thomas-lamure/totobox/docs/api.md

# API embarquée

La page web ([web/](../web)) ne parle à la boîte que par cette API JSON locale. Elle reste simple et utilisable depuis un script (`curl`). Le faux serveur de développement ([scripts/mock-server.mjs](../scripts/mock-server.mjs), voir [development.md](development.md#page-web)) l'imite sans matériel.

Erreurs communes: `403 locked` (réglages verrouillés), `503 busy_playing` (accès à la carte SD refusé pendant la lecture), `503 busy_downloading` (même chose pendant un téléchargement), `403 forbidden_host`, `403 forbidden_origin` et `415 json_required` (voir « Protection contre les autres sites »).

Colonnes « Verrouillée » et « En lecture »: la route est-elle servie? Elles reprennent la table du firmware ([src/api_routes.cpp](../src/api_routes.cpp)), vérifiée par `make test-scripts`.

| Route | Verrouillée | En lecture | Rôle |
|---|---|---|---|
| `GET /` | oui | oui | page web |
| `GET /api/status` | oui | oui | état, lecture en cours, volume, verrouillage, SD |
| `POST /api/volume` | oui | oui | `{volume}` borné aux limites |
| `POST /api/unlock` | oui | oui | `{pin}`; 5 erreurs = 60 s de blocage |
| `POST /api/lock` | oui | oui | reverrouille |
| `GET /api/config` | non | oui | réglages, bindings, cartes maîtresses |
| `POST /api/config` | non | oui | réglages (mot de passe absent = inchangé), `hostname`, `updateNotify`, `autoUpdate`, Home Assistant (voir plus bas); validés, réseau appliqué sans redémarrage |
| `POST /api/bindings` | non | oui | remplace la liste des cartes |
| `POST /api/lock/setup` | non | oui | `{enabled:true, cardUid, cardLabel, pin}` ou `{enabled:false}` |
| `POST /api/lock/pin` | non | oui | `{pin}` |
| `POST /api/lock/cards` | non | oui | `{action:"add"/"remove", cardUid, cardLabel}` |
| `GET /api/library` | non | non | arborescence de `/content`, espace SD |
| `POST /api/upload` | non | non | multipart, tags ID3 retirés à l'écriture. La page envoie un fichier par requête (file d'envoi annulable); un envoi interrompu (annulé, connexion perdue) efface le fichier à moitié écrit |
| `GET /api/download?path=` | non | non | fichier audio de `/content` (hors corbeille) en pièce jointe (`Content-Disposition`, nom UTF-8); un dossier part en archive ZIP sans compression (`dossier.zip`, `totobox.zip` pour `/content`, sous-dossiers compris, fichiers audio seulement, 2000 fichiers et 4 Go au plus). Envoyé par morceaux sans bloquer la boîte, interrompu si une histoire démarre. Un seul à la fois. Erreurs: `invalid_path`, `not_found`, `sd_unavailable`, `empty_folder`, `too_many_files`, `too_large` |
| `POST /api/folder` | non | non | crée un dossier |
| `POST /api/rename` | non | non | renomme fichier ou dossier |
| `POST /api/move` | non | non | `{path, targetDir}`: déplace fichier ou dossier, renvoie `movedPath` |
| `POST /api/delete` | non | non | déplace vers `/content/.trash` |
| `GET /api/trash` | non | non | contenu de la corbeille |
| `POST /api/restore` | non | non | restaure depuis la corbeille; les dossiers de la corbeille vidés sont retirés |
| `POST /api/trash/purge` | non | non | vide la corbeille, ou `{path}`: supprime définitivement un seul élément de la corbeille (les dossiers de la corbeille vidés sont retirés) |
| `GET /api/cards/backup` | non | non | sauvegarde présente sur la SD: `exists`, `count`, `savedAt` |
| `POST /api/cards/backup` | non | non | `{savedAt}`: sauvegarde les cartes dans `/totobox-cartes.json` (remplace la précédente) |
| `POST /api/cards/restore` | non | non | remplace les cartes par celles de la sauvegarde (cartes maîtresses ignorées) |
| `POST /api/setup/complete` | non | oui | assistant de première connexion terminé (ou remis à plus tard) |
| `POST /api/factory-reset` | non | non | `{confirm:"EFFACER", savedAt}`: sauvegarde les cartes sur la SD, efface la configuration et redémarre; renvoie `apSsid`, `backupSaved` |
| `POST /api/update` | non | non | `{version, uiVersion, firmware: {url, sha256, size}, page: {url, sha256, size}}`: télécharge et installe une version publiée, puis redémarre (voir « Mise à jour en ligne ») |
| `POST /api/sd/format` | non | — | `{confirm:"FORMATER"}`: formate en FAT32 une carte illisible (refusé si elle est lisible) |

`GET /api/status` renvoie notamment:

- `features`: fonctions compilées, `onlineUpdate` (mise à jour en ligne) et `homeAssistant`; toutes deux à `false` dans la variante hors ligne (voir [development.md](development.md#variante-hors-ligne)), où `updateRepo` est vide, `homeAssistant` et `update` absents, et `POST /api/update` répond `404 not_available`. Absent sur les firmwares d'avant 1.3.0: tout est présent;
- `firmwareVersion` (version publiée, voir [CHANGELOG.md](../CHANGELOG.md)) et `firmwareBuild` (commit compilé, `-dirty` si modifié);
- `state`, `audioPlaying`, `stoppedRemotely` (lecture arrêtée depuis Home Assistant, carte toujours posée: `state` vaut `paused`), `activeCardUid`, `activeCardLabel`, `activeMediaPath`, `activeTrackIndex`, `activeTrackCount`, `activePositionMs`, `activeDurationMs` (durée de la piste en cours, 0 si pas encore connue);
- `currentVolume`, `volumeMin`, `volumeMax`;
- `lockEnabled`, `locked`, `lastUnknownCardUid` (vide si verrouillée);
- `sdReady`, `sdState` (`absent`, `unreadable`: présente mais pas en FAT32, `ready`) et l'espace SD en octets: `sdTotalBytes`, `sdUsedBytes`, `sdFreeBytes` (dernières valeurs connues pendant la lecture);
- `wifiConnected`, `wifiMode`, `wifiSsid`, `wifiIp`, `hostname`, `networkAttempt` (dernier changement de Wi-Fi lancé depuis la page: `id`, augmenté à chaque essai, `state` = `trying`, `connected`, `failed` ou vide, `ssid`, `ip`, `error` et `apClosesInSec`, secondes avant la fermeture du point d'accès);
- `nfcReady` (lecteur NFC détecté) et `bindingsCount` (nombre de cartes associées);
- `setupDone` (faux: la page ouvre l'assistant de première connexion);
- `uiVersion` (version de la page dans LittleFS: une page plus ancienne propose de se recharger);
- `boxKey` et `challenge` (canal chiffré des secrets, voir plus bas);
- `updateRepo` (dépôt GitHub des versions, `propriétaire/nom`), `updateNotify` et `autoUpdate` (réglages des mises à jour, aussi dans `/api/config` avec `lastUpdateCheck`, date de la dernière recherche automatique en secondes depuis 1970), et `update` (mise à jour en ligne: `phase` = `idle`, `checking` (recherche automatique), `page`, `firmware`, `restarting` ou `failed`, `version`, `done` et `total` en octets du fichier en cours, `error`).

- `homeAssistant` (absent si verrouillée): `enabled`, `state` (`off`, `connecting`, `connected`, `error`) et `error` (`invalid_address`, `no_wifi`: pas connectée au Wi-Fi de la maison, `dns`, `unreachable`, `auth`).

`GET /api/config` renvoie les réglages (`volumeMin`, `volumeMax`, `currentVolume`, `wifiSsid`, `apSsid`, `hostname`, `updateNotify`, `autoUpdate`, `lastUpdateCheck`, `lockEnabled`, Home Assistant ci-dessous), les cartes maîtresses `lockCards` (`uid`, `label`) et les cartes associées `bindings`, la liste que `POST /api/bindings` remplace en entier:

- `uid`, `label`, `mediaPath` (fichier ou dossier dans `/content`), `mode` (`sd_local`);
- le signet: `resumeTrackIndex`, `resumeMs` et `resumeByte` (position dans le fichier, 0 si inconnue);
- l'apparence dans la page, absente si elle est par défaut: `emoji` (16 octets au plus) et `color` (`blue`, `green`, `amber`, `red`, `purple`, `pink`, `teal`). Une valeur invalide est ignorée.

Réglages Home Assistant ([home-assistant.md](home-assistant.md)), dans `GET` et `POST /api/config`: `haEnabled`, `haAddress` (adresse de Home Assistant ou du broker MQTT: nom, IP, `hôte:port`, `mqtt://hôte:port` ou adresse de la page Home Assistant, dont le port web est ignoré; `homeassistant.local` par défaut), `mqttUser`, `mqttPassword` (secret: envoyé chiffré, jamais renvoyé; `GET` donne seulement `mqttPasswordSet`; absent = inchangé, vide = effacé). Erreurs: `invalid_ha_address`, `ha_tls_unsupported` (`mqtts://`, pas encore pris en charge), `invalid_mqtt_user`, `invalid_mqtt_password` (64 caractères au plus). L'adresse est vérifiée quand elle change et quand la liaison est activée.

Les créations et renommages refusent les noms réservés ou ambigus comme `.`, `..`, `.trash`, `trash` et `content`.

## Protection contre les autres sites

Une page web malveillante ouverte sur un appareil du réseau local ne peut pas piloter la boîte ([src/request_guard.h](../src/request_guard.h)):

- toute route `/api` refuse les requêtes adressées à un autre nom que la boîte (son nom `.local`, son IP ou 192.168.4.1): protection contre le rebinding DNS (`403 forbidden_host`);
- toute modification venue d'une autre origine (en-têtes `Origin`, `Sec-Fetch-Site`) est refusée (`403 forbidden_origin`), de même qu'un corps qui n'est pas en `application/json` (`415 json_required`).

Les scripts restent possibles: `curl -H "Content-Type: application/json" -d '{"volume":40}' http://totobox.local/api/volume`.

## Mise à jour en ligne

La page cherche la dernière version sur l'API GitHub (`https://api.github.com/repos/<updateRepo>/releases/latest`, qui autorise les pages d'autres origines). Les notes de chaque version contiennent un commentaire HTML invisible, `<!-- totobox-update {...} -->`, écrit par `scripts/release.py update-block`, qui donne la version de la page, la taille et l'empreinte SHA-256 des fichiers `totobox-X.Y.Z-firmware.bin` et `totobox-X.Y.Z-page.html.gz`; la page y ajoute leurs adresses de téléchargement et l'envoie à `POST /api/update`.

GitHub ne sert pas ces fichiers aux pages d'une autre origine: la boîte les télécharge elle-même ([src/update_service.h](../src/update_service.h)), en vérifiant le certificat du serveur avec les autorités racines de Mozilla. Elle n'accepte ([src/update_rules.h](../src/update_rules.h)) que les fichiers des Releases du dépôt `updateRepo`, d'une version plus récente que la sienne, aux tailles plausibles, et vérifie leur empreinte avant de les installer:

1. la page est écrite à côté de l'actuelle dans LittleFS;
2. le firmware est écrit dans la partition OTA inactive (`app0`/`app1`): un échec ou une coupure de courant laisse l'ancien démarrer;
3. ensuite seulement, la page remplace l'ancienne, la nouvelle partition devient celle du démarrage, et la boîte redémarre.

En mode automatique (`autoUpdate`), la boîte fait elle-même la recherche une fois par jour: `GET https://api.github.com/repos/<updateRepo>/releases/latest`, même lecture des notes (`update_rules::parseRelease`), mêmes contrôles, puis la même installation (`update.phase` passe par `checking`). Conditions (`update_rules::shouldAutoCheck`): Wi-Fi de la maison, heure NTP connue, 24 h depuis `lastUpdateCheck`, et une minute sans lecture ni carte posée (réveil compris). GitHub injoignable: nouvel essai une heure plus tard.

Erreurs (`409`): `no_internet` (pas connectée au Wi-Fi de la maison), `not_newer`, `invalid_url`, `invalid_hash`, `invalid_size`, `invalid_version`, `invalid_ui_version`, `update_running`. Pendant le téléchargement, `update.error` peut valoir `download_failed`, `download_incomplete`, `hash_mismatch`, `invalid_image`, `no_space` ou `write_failed`.

## Secrets chiffrés

L'interface est servie en HTTP. Les mots de passe Wi-Fi (maison et point d'accès) et le code de secours ne circulent pas en clair: la page les chiffre avec la clé publique de la boîte (`boxKey`, X25519 + XSalsa20-Poly1305, `nacl.box`; tweetnacl-js embarqué côté page, libsodium côté boîte, [src/secret_channel.h](../src/secret_channel.h)). La paire de clés est tirée au premier démarrage et effacée par la remise à zéro. Un défi aléatoire (`challenge`), renouvelé après chaque utilisation, empêche de rejouer une requête enregistrée.

Cela protège d'une écoute passive du réseau, pas de quelqu'un qui s'interpose et remplace la clé ou la page. Les requêtes en clair restent acceptées (scripts).
