thomas-lamure/totobox/hardware/laser/totobox_manuel_plan_de_coupe.pdf

# TotoBox, version fabriquée à la main: plan de coupe à la scie

Contreplaqué de 3 mm, plaque de 300 × 200 (au moins 275 × 176). Cotes en mm, pièces vues de leur face intérieure. Mesurer depuis le bord qui vient d'être scié et scier du côté chute du trait: la lame mange 2 mm, déjà prévus entre les pièces.

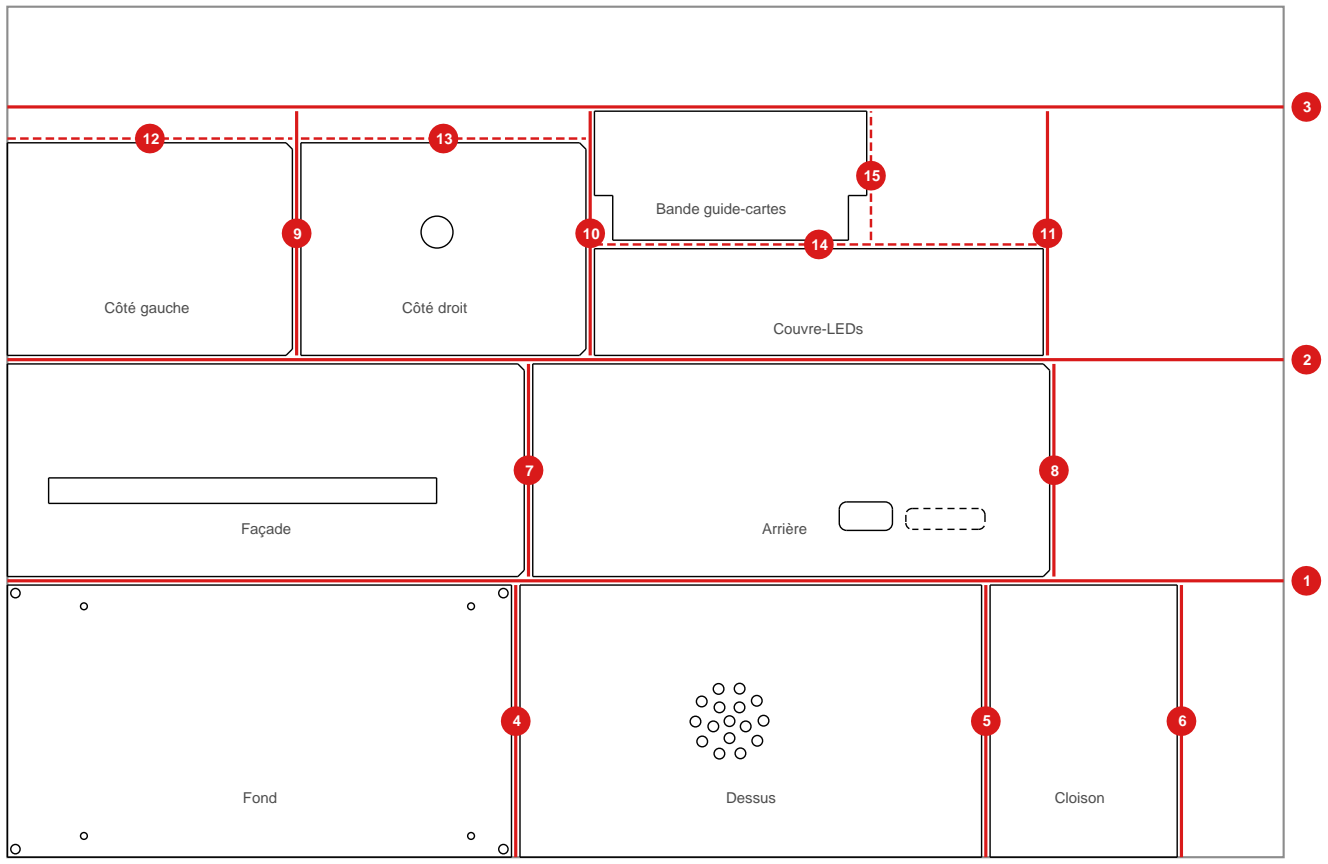
[picture p3: figure]
Fond; Façade; Côté gauche; Arrière; Côté droit; Cloison; Couvre-LEDs; Dessus; Bande guide-cartes

plaque 300 × 200; bords de départ: en bas et à gauche

## Ordre des coupes

N° | Où | Cote | Résultat

Traits horizontaux, sur toute la longueur de la plaque
1 | Plaque, depuis le bas | 64 | bande A (64 de haut)
2 | Plaque, depuis le trait 1 | 50 | bande B (50 de haut)
3 | Plaque, depuis le trait 2 | 57,4 | bande C (57,4 de haut), le reste est une chute
Traits verticaux, dans chaque bande
4 | Bande A, depuis la gauche | 118,5 | Fond 118,5 × 64
5 | Bande A, depuis le trait 4 | 108,5 | Dessus 108,5 × 64
6 | Bande A, depuis le trait 5 | 44 | Cloison 44 × 64
7 | Bande B, depuis la gauche | 121,5 | Façade 121,5 × 50
8 | Bande B, depuis le trait 7 | 121,5 | Arrière 121,5 × 50
9 | Bande C, depuis la gauche | 67 | ébauche: Côté gauche 67 × 57,4
10 | Bande C, depuis le trait 9 | 67 | ébauche: Côté droit 67 × 57,4
11 | Bande C, depuis le trait 10 | 105,5 | bloc Couvre-LEDs + Bande guide-cartes 105,5 × 57,4
Recoupes (pointillés sur le schéma)
12 | Côté gauche (ébauche), depuis le bas | 50 | Côté gauche 67 × 50
13 | Côté droit (ébauche), depuis le bas | 50 | Côté droit 67 × 50
14 | Bloc du trait 11, depuis le bas | 25,1 | Couvre-LEDs 105,5 × 25,1
15 | Bande guide-cartes (ébauche), depuis la gauche | 64 | Bande guide-cartes 64 × 30,3

Encoches, chanfreins, biseaux et perçages en page 2.

# Finitions et perçages

Coordonnées (x ; y) en mm depuis le coin bas gauche de la pièce posée face intérieure vers soi, dans le sens du schéma de la page 1 (x vers la droite, y vers le haut). Ø: diamètre du foret, au centre indiqué.

### Fond (118,5 × 64)

4 × Ø1,6: (18 ; 5) (109 ; 5) (18 ; 59) (109 ; 59)
4 × Ø2,2: (1,9 ; 1,9) (116,6 ; 1,9) (1,9 ; 62,1) (116,6 ; 62,1)

### Façade (121,5 × 50)

Chanfrein de 1,5 × 1,5 aux coins bas droit et haut droit, à la lime ou au ponçage. Fente 91,2 × 6: de x = 9,7 à 100,9, de y = 17,2 à 23,2, angles vifs.

### Côté gauche (67 × 50)

Chanfrein de 1,5 × 1,5 aux coins bas droit et haut droit, à la lime ou au ponçage.

### Arrière (121,5 × 50)

Chanfrein de 1,5 × 1,5 aux coins bas droit et haut droit, à la lime ou au ponçage.
Fente 12,5 × 6,7: de x = 72,05 à 84,55, de y = 10,85 à 17,55,
coins R1,75: 4 × Ø3,5 en (73,8 ; 12,6) (82,8 ; 12,6) (73,8 ; 15,8) (82,8 ; 15,8), puis scier ou limer entre. Fente microSD (optionnel) 18,6 × 4,9: de x = 87,7 à 106,3, de y = 11,1 à 16,
coins R1,5: 4 × Ø3 en (89,2 ; 12,6) (104,8 ; 12,6) (89,2 ; 14,5) (104,8 ; 14,5), puis scier ou limer entre.

### Côté droit (67 × 50)

Chanfrein de 1,5 × 1,5 aux coins bas droit et haut droit, à la lime ou au ponçage.
1 × Ø7,5: (32 ; 29)

### Cloison (44 × 64)

Rien à faire après la découpe.

### Couvre-LEDs (105,5 × 25,1)

Tracé par sa grande face: biseau à 45° de ses deux grands bords au ponçage.

### Dessus (108,5 × 64)

16 × Ø2,5: (46,9 ; 24,4) (51,8 ; 24,4) (42,8 ; 27,2) (55,8 ; 27,4) (49,2 ; 28) (45,4 ; 30,8) (53,1 ; 30,8) (41,2 ; 31,9) (49,2 ; 32) (57,2 ; 32,1) (46,9 ; 35,2) (51,6 ; 35,2)
(42,7 ; 36,6) (55,7 ; 36,8) (46,7 ; 39,6) (51,6 ; 39,6)

### Bande guide-cartes (64 × 30,3)

Encoche de 4,3 de large × 10,5 de haut aux coins bas gauche et bas droit (deux traits de scie). Découpée droite: biseau à 80° au ponçage.

Pour pointer les trous, le gabarit totobox_manuel_calepinage_a4.pdf (échelle 1:1, à imprimer) reste le plus sûr.
