thomas-lamure/totobox/hardware/laser/totobox_castle_bande_guide.dxf

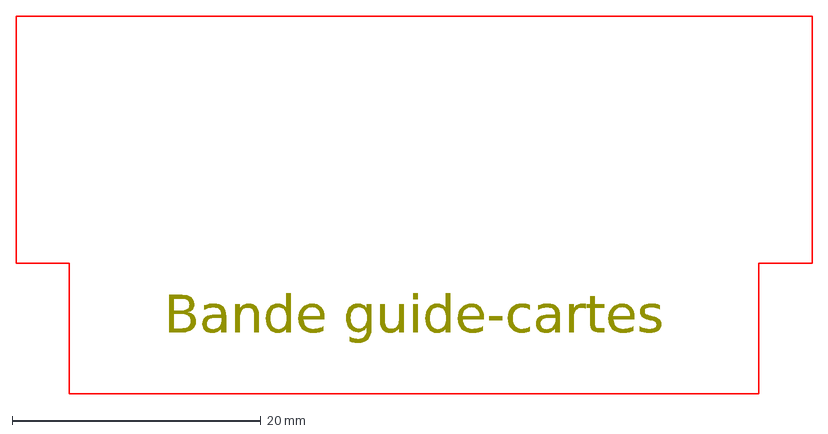
[picture p4: CAD file, 2026-11-04]
hardware/laser/totobox_castle_bande_guide.dxf
Bande guide-cartes
