thomas-lamure/totobox/hardware/laser/totobox_castle_cloison.dxf

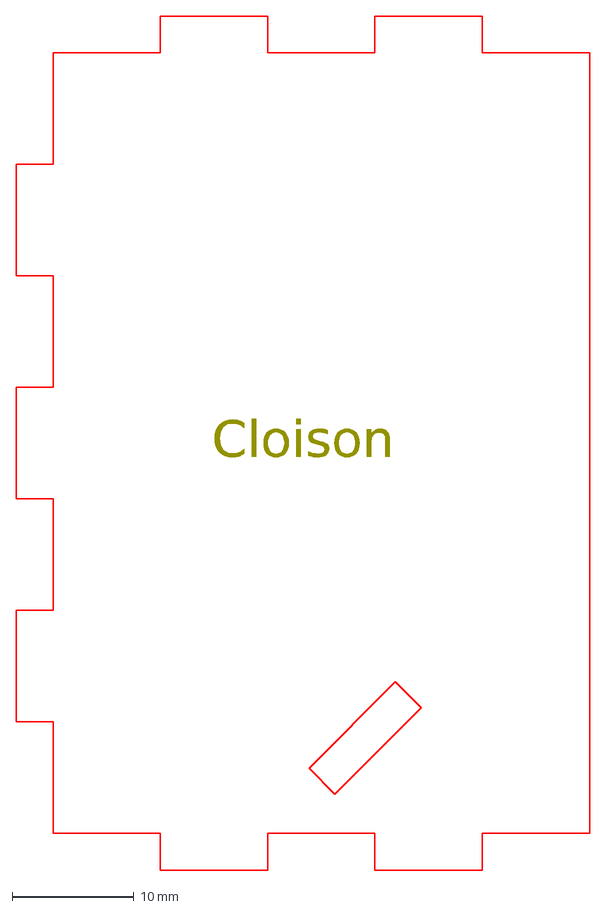
[picture p5: CAD file, 2026-11-04]
hardware/laser/totobox_castle_cloison.dxf
Cloison
