thomas-lamure/totobox/hardware/laser/totobox_manuel_dessus.dxf

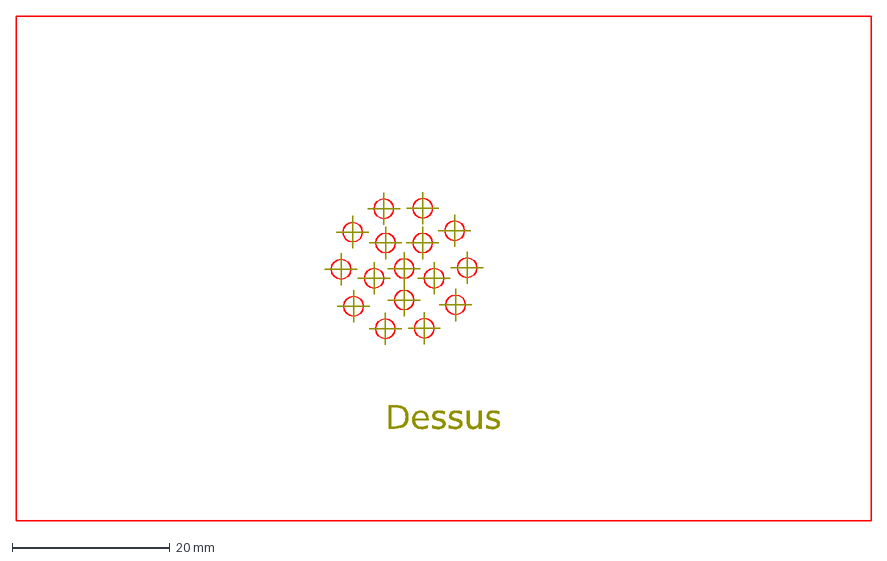
[picture p6: CAD file, 2026-11-04]
hardware/laser/totobox_manuel_dessus.dxf
Dessus
