thomas-lamure/totobox/hardware/laser/totobox_castle_plaque.dxf

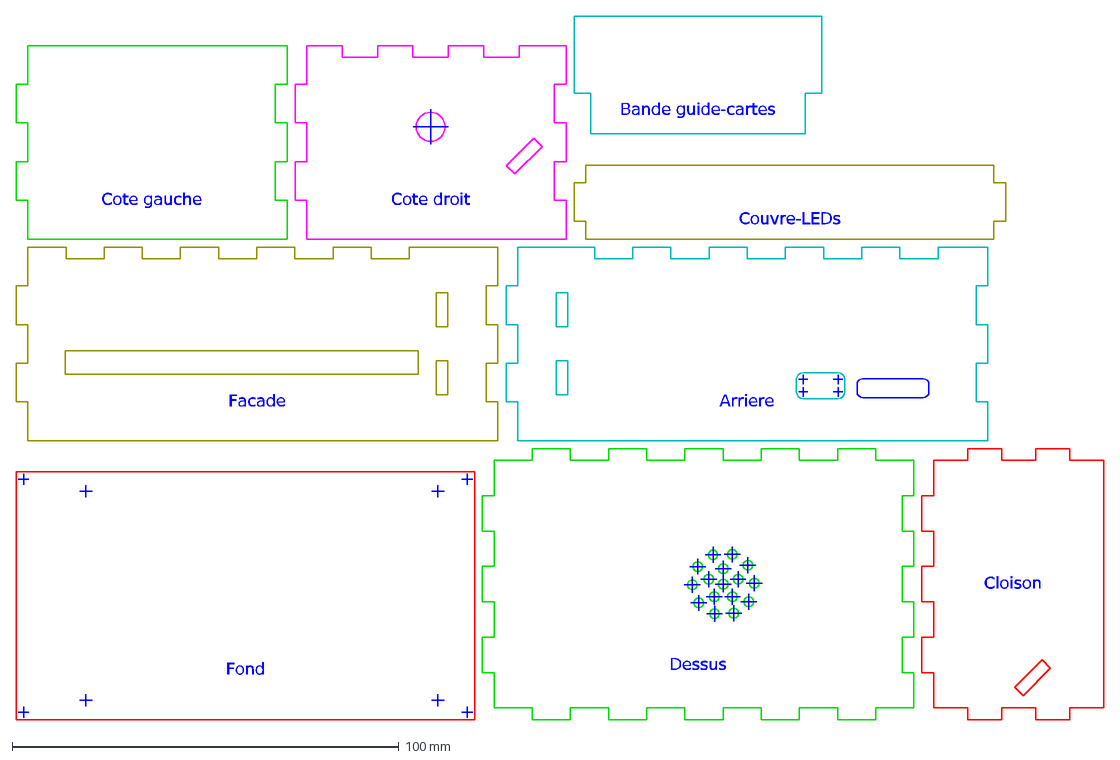
[picture p7: CAD file, 2026-11-04]
hardware/laser/totobox_castle_plaque.dxf
Fond
Facade
Cote gauche
Arriere
Cote droit
Cloison
Couvre-LEDs
Dessus
Bande guide-cartes
