thomas-lamure/totobox/hardware/laser/totobox_manuel_cote_gauche.dxf

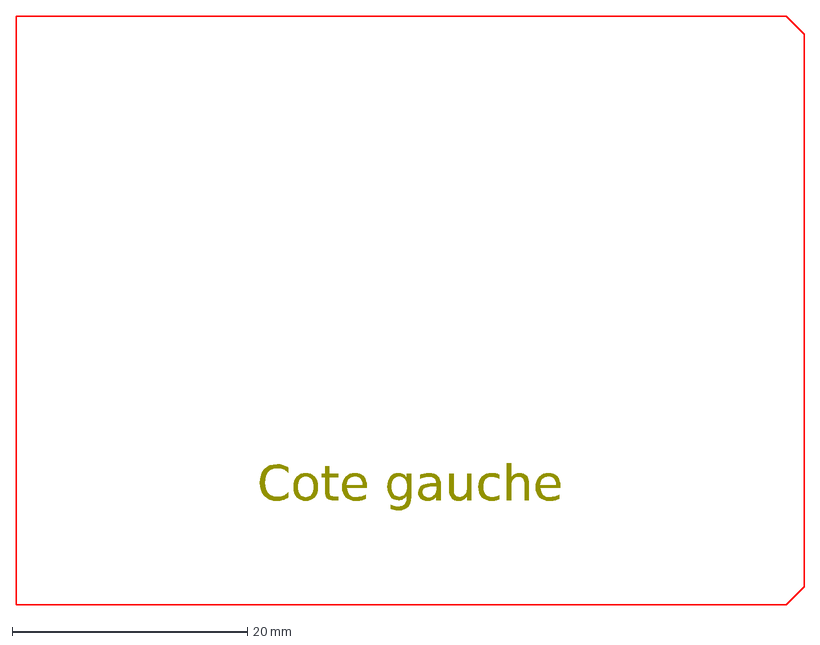
[picture p8: CAD file, 2026-11-04]
hardware/laser/totobox_manuel_cote_gauche.dxf
Cote gauche
