thomas-lamure/totobox/hardware/laser/totobox_manuel_arriere.dxf

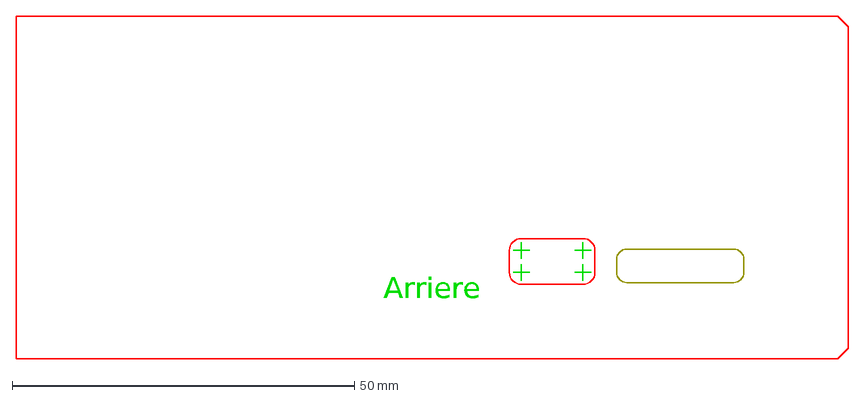
[picture p9: CAD file, 2026-11-04]
hardware/laser/totobox_manuel_arriere.dxf
Arriere
