thomas-lamure/totobox/hardware/laser/totobox_manuel_facade.dxf

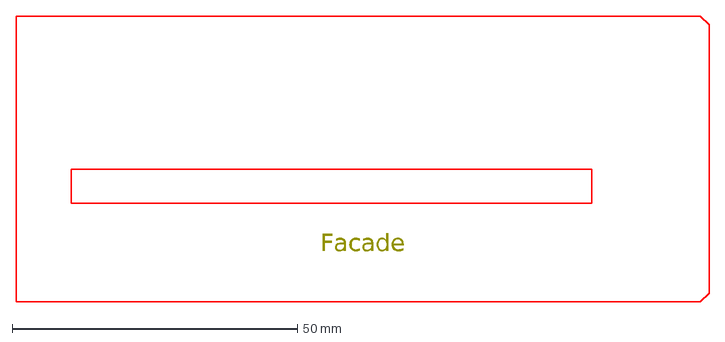
[picture p10: CAD file, 2026-11-04]
hardware/laser/totobox_manuel_facade.dxf
Facade
