thomas-lamure/totobox/hardware/laser/totobox_castle_facade.dxf

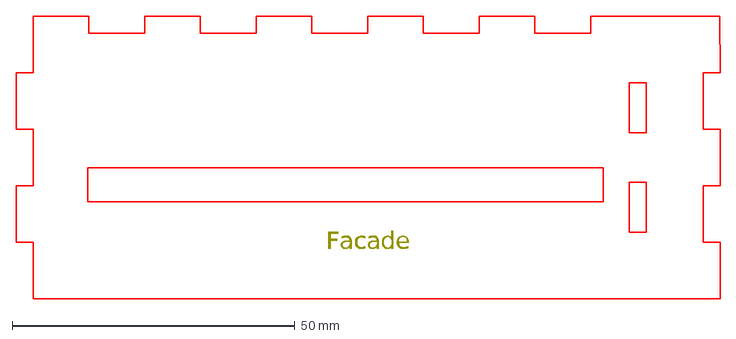
[picture p11: CAD file, 2026-11-04]
hardware/laser/totobox_castle_facade.dxf
Facade
