thomas-lamure/totobox/hardware/laser/totobox_manuel_couvre_leds.dxf

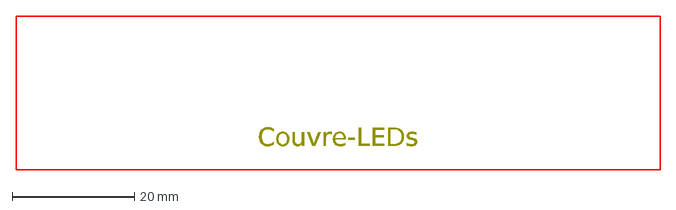
[picture p12: CAD file, 2026-11-04]
hardware/laser/totobox_manuel_couvre_leds.dxf
Couvre-LEDs
