thomas-lamure/totobox/hardware/laser/totobox_castle_cote_gauche.dxf

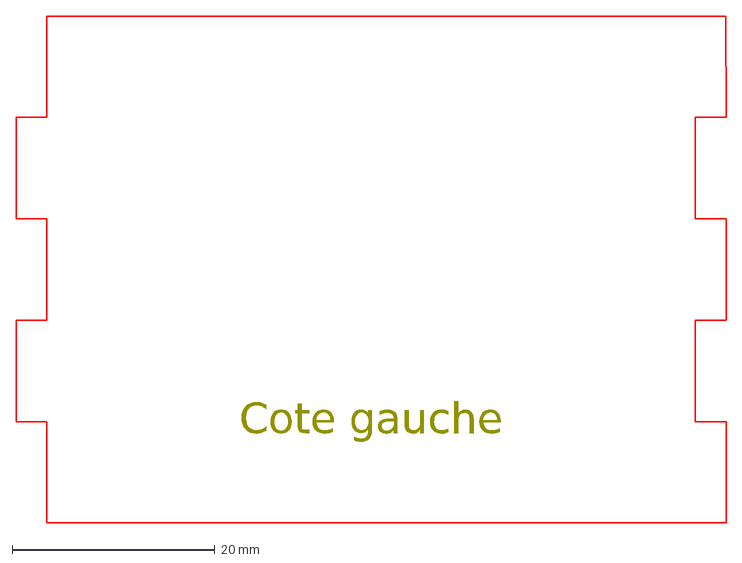
[picture p13: CAD file, 2026-11-04]
hardware/laser/totobox_castle_cote_gauche.dxf
Cote gauche
