thomas-lamure/totobox/hardware/laser/totobox_castle_cote_droit.dxf

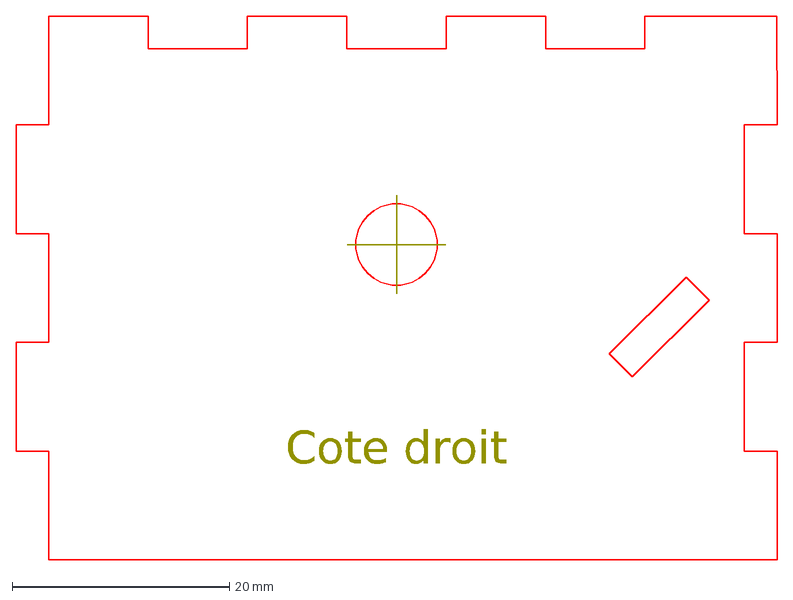
[picture p14: CAD file, 2026-11-04]
hardware/laser/totobox_castle_cote_droit.dxf
Cote droit
