thomas-lamure/totobox/hardware/laser/totobox_manuel_fond.dxf

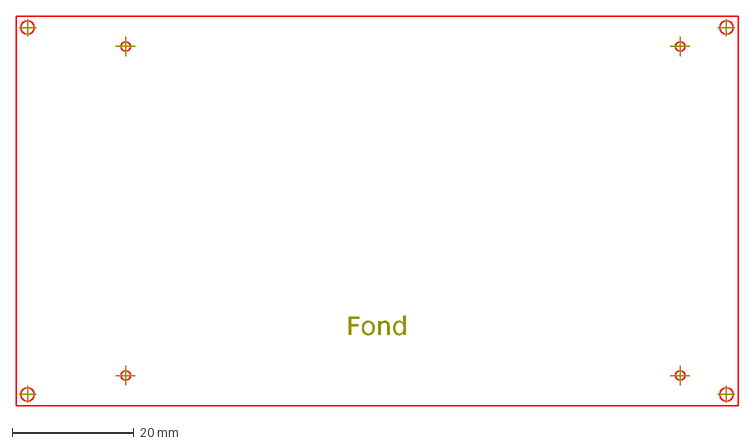
[picture p15: CAD file, 2026-11-04]
hardware/laser/totobox_manuel_fond.dxf
Fond
