thomas-lamure/totobox/hardware/laser/totobox_manuel_plaque.dxf

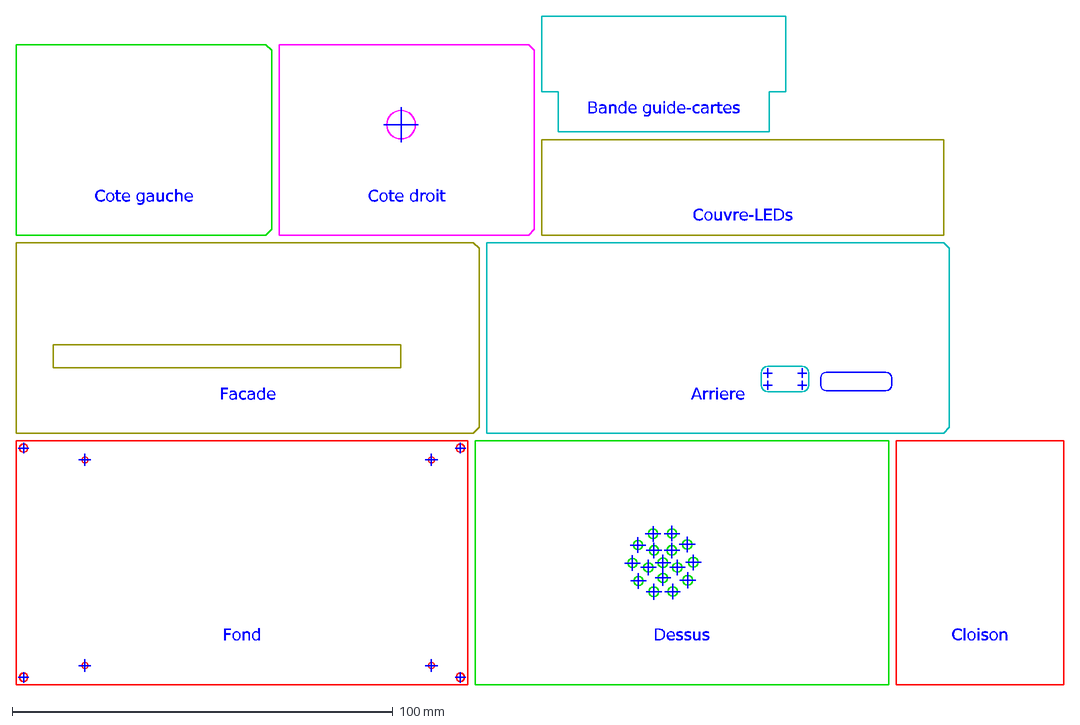
[picture p16: CAD file, 2026-11-04]
hardware/laser/totobox_manuel_plaque.dxf
Fond
Facade
Cote gauche
Arriere
Cote droit
Cloison
Couvre-LEDs
Dessus
Bande guide-cartes
