thomas-lamure/totobox/hardware/laser/totobox_castle_arriere.dxf

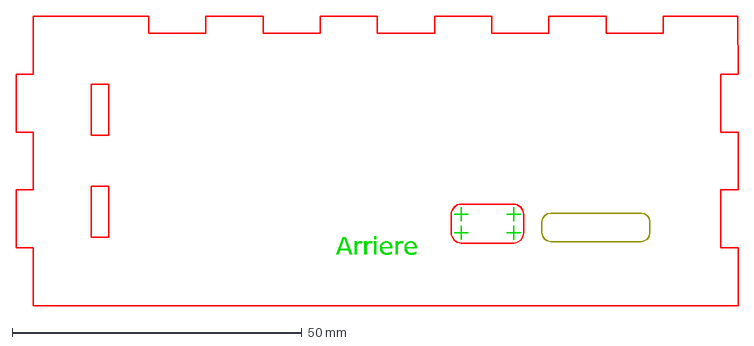
[picture p17: CAD file, 2026-11-04]
hardware/laser/totobox_castle_arriere.dxf
Arriere
