thomas-lamure/totobox/hardware/laser/totobox_castle_fond.dxf

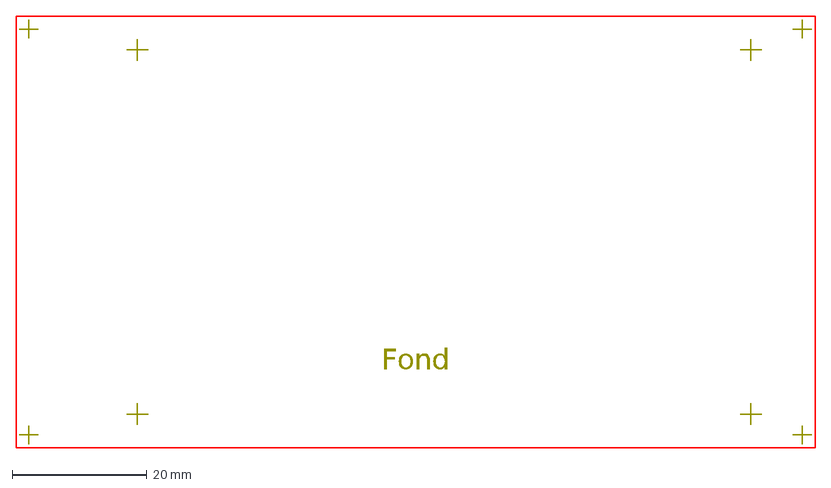
[picture p18: CAD file, 2026-11-04]
hardware/laser/totobox_castle_fond.dxf
Fond
