thomas-lamure/totobox/hardware/laser/totobox_manuel_cloison.dxf

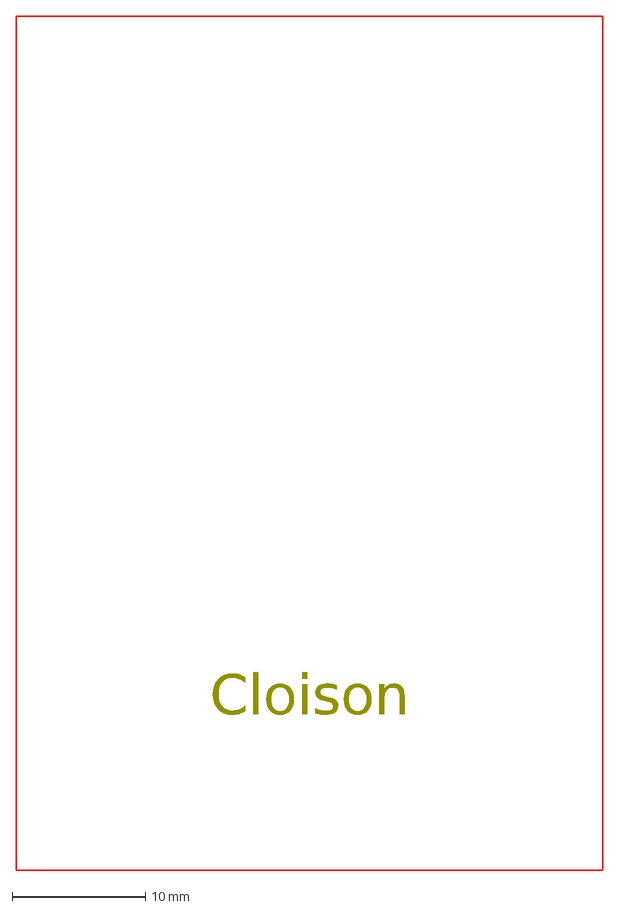
[picture p19: CAD file, 2026-11-04]
hardware/laser/totobox_manuel_cloison.dxf
Cloison
