thomas-lamure/totobox/hardware/laser/totobox_castle_couvre_leds.dxf

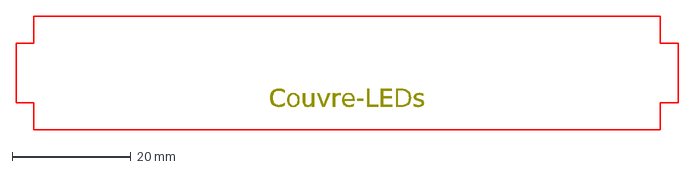
[picture p20: CAD file, 2026-11-04]
hardware/laser/totobox_castle_couvre_leds.dxf
Couvre-LEDs
