thomas-lamure/totobox/hardware/laser/totobox_manuel_cote_droit.dxf

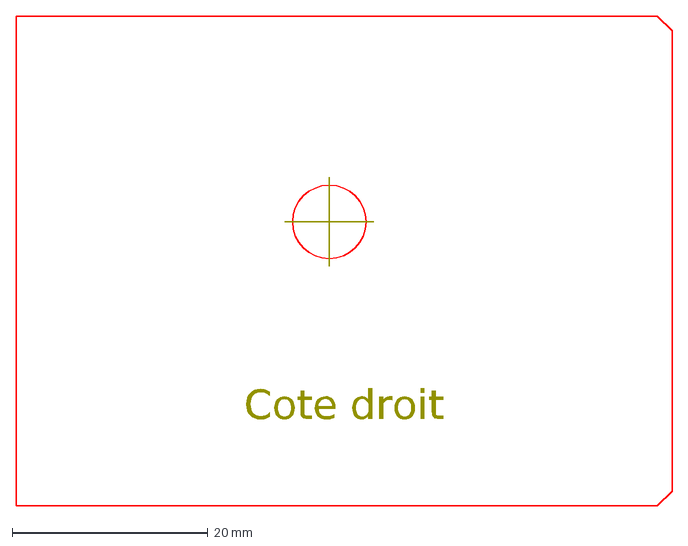
[picture p21: CAD file, 2026-11-04]
hardware/laser/totobox_manuel_cote_droit.dxf
Cote droit
