thomas-lamure/totobox/hardware/laser/totobox_castle_dessus.dxf

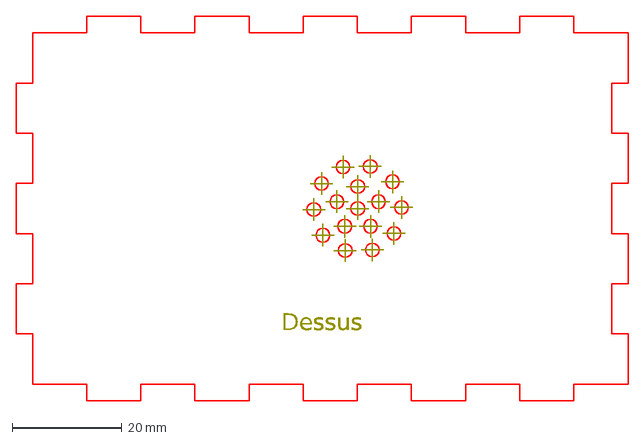
[picture p22: CAD file, 2026-11-04]
hardware/laser/totobox_castle_dessus.dxf
Dessus
