thomas-lamure/totobox/hardware/laser/totobox_castle_calepinage_a4.pdf

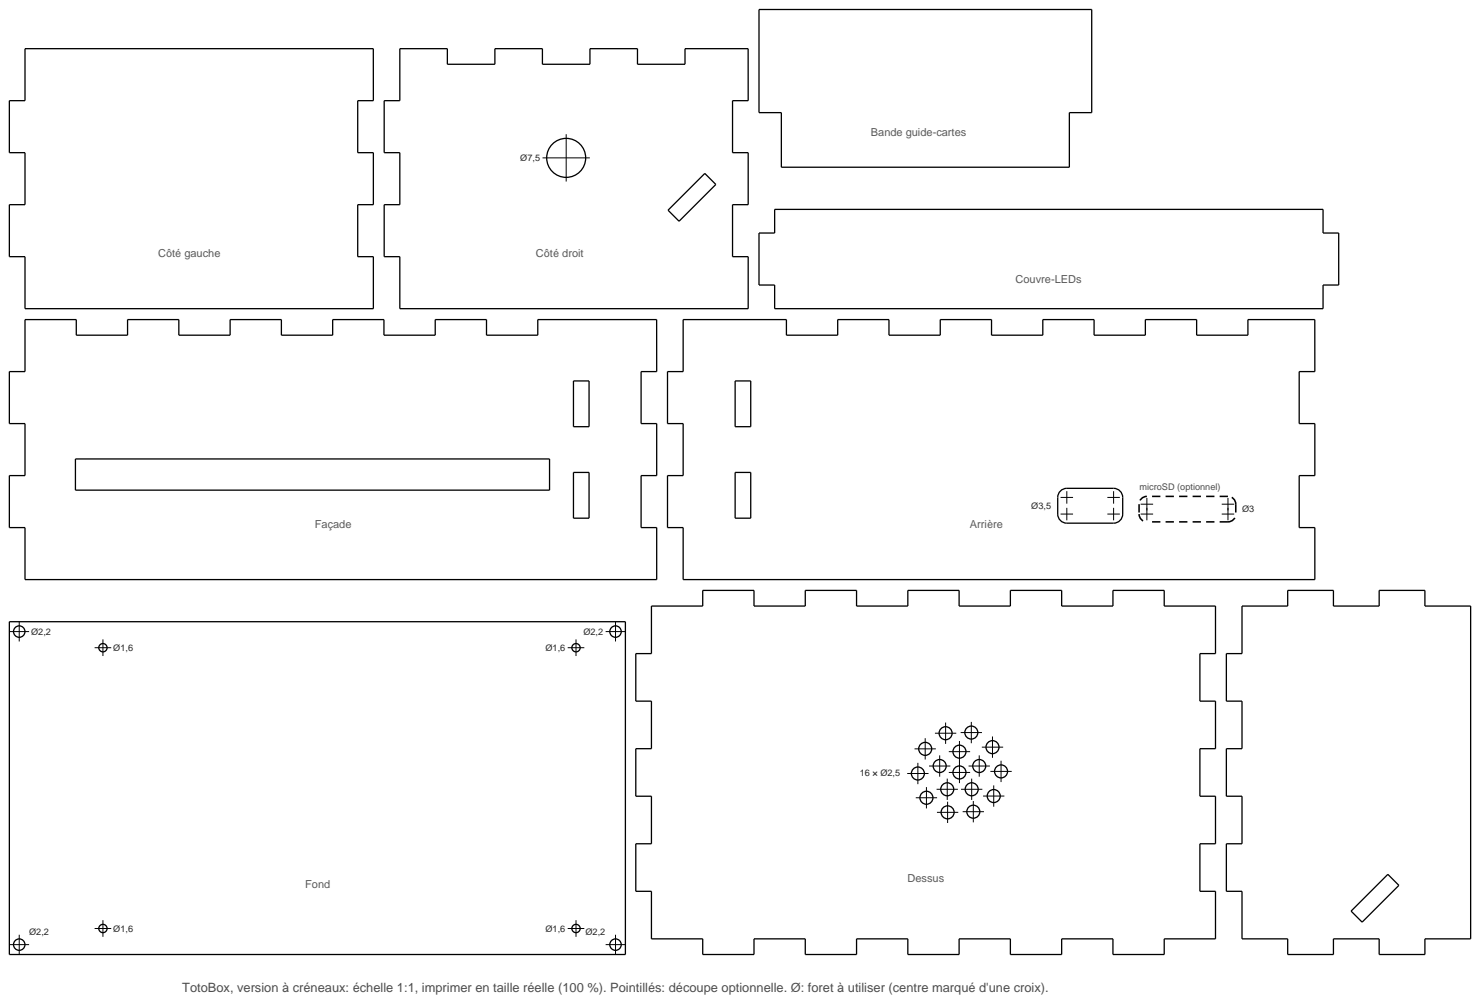
[picture p23: page 1]
Fond; Façade; Côté gauche; Arrière; microSD (optionnel); Côté droit; Couvre-LEDs; Dessus

Bande guide-cartes

TotoBox, version à créneaux: échelle 1:1, imprimer en taille réelle (100 %). Pointillés: découpe optionnelle. Ø: foret à utiliser (centre marqué d'une croix).
