thomas-lamure/totobox/hardware/laser/totobox_manuel_calepinage_a4.pdf

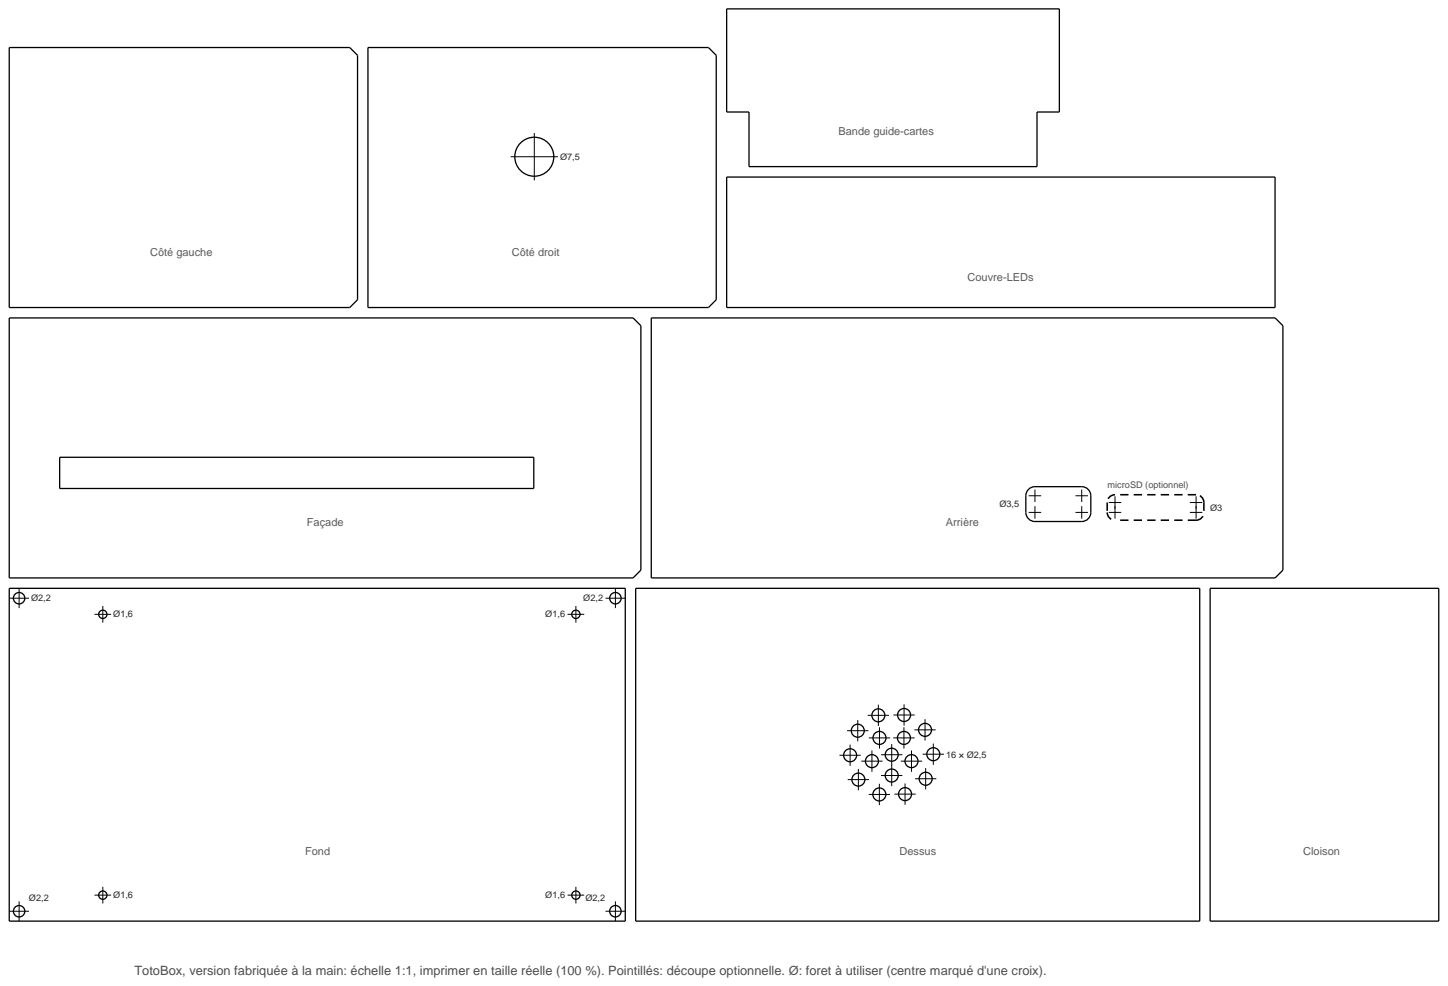
[picture p24: page 1]
Fond; Façade; Côté gauche; Arrière; microSD (optionnel); Côté droit; Cloison; Couvre-LEDs; Dessus

Bande guide-cartes

TotoBox, version fabriquée à la main: échelle 1:1, imprimer en taille réelle (100 %). Pointillés: découpe optionnelle. Ø: foret à utiliser (centre marqué d'une croix).
