thomas-lamure/totobox/(commit log)

2026-10-28 TotoBox 1.0.0
    Story and music box for young children: ESP32-S3 firmware (HermitX CardReader),
    phone-friendly web settings page and 3 mm plywood enclosure.
    [partitions.csv, totobox_castle_arriere.dxf, totobox_castle_bande_guide.dxf, totobox_castle_cloison.dxf, totobox_castle_cote_droit.dxf, totobox_castle_cote_gauche.dxf, totobox_castle_couvre_leds.dxf, totobox_castle_dessus.dxf]
2026-10-28 CI: actions on Node 24, pinned Ubuntu image, README badge
    Bump checkout, setup-python, setup-node and cache to their Node 24 majors
    (Node 20 actions are deprecated), reuse-action to v6, and pin ubuntu-24.04
    instead of ubuntu-latest, which moves to Ubuntu 26.
2026-10-28 Card flow, device rules and web page functions in tested modules
    card_flow: card presented (master, unknown, known), removal confirmed after the
    grace delay, bookmarks, story end, SD card lost and back, unknown card bound
    from the page (16 native tests). A card swapped for another within 250 ms now
    stops the current story and keeps its bookmark first; before, the bookmark was
    lost and a master card left the story playing with no card on the reader.
    volume_rules, led_layout, retry_delay: knob detents within the limits, LED
    gauge, strip order and chase, Wi-Fi retry delay (8 native tests).
    web/lib.js: pure page functions (escaping, formats, host and folder names, ID3
    stripping, bindings follo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
    [app_types.h, card_flow.cpp, card_flow.h, led_controller.cpp, led_layout.h, main.cpp, network_service.cpp]
2026-10-28 Release 1.0.1
    Card swap and /content trash fixes, logic moved into tested modules (see
    CHANGELOG.md). The mock server now reads the firmware version from
    include/version.h, and docs/development.md describes how to release a version.
    [version.h]
2026-10-28 Automated releases and online update from the web page
    Release: make release VERSION=X.Y.Z bumps include/version.h, closes the
    CHANGELOG section, commits and tags; pushing the tag runs release.yml, which
    checks the version, tests, builds and publishes a GitHub Release with the
    changelog notes and downloads: full image for a first install without
    PlatformIO (pio run -t merged), firmware and page for updates, page alone for
    online updates, cut files and checksums.
    Online update: the page checks the latest GitHub release when it opens and
    once a day, then shows a banner and an install dialog with progress. The box
    downloads the files itself (GitHub serves no CORS headers on release assets)
    ove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
2026-10-28 Quieter serial console
    The update service checks files with stat() before removing them: LittleFS
    exists() and remove() logged a framework error for every missing file (at boot
    and during an update). Framework logs are now limited to errors
    (CORE_DEBUG_LEVEL=1): its info and warning lines, written without the logLine
    lock, interleaved with the box's own lines during TLS downloads, and
    WebServer::streamFile warned on every page load.
    [update_service.cpp]
2026-10-28 Online update: verify the stored page before switching
    After writing the new page to LittleFS, read it back and check its size and
    SHA-256 before installing the firmware (and again after the rename). File::write
    is buffered and reports success even when the data never reaches the flash, so
    a short write went unnoticed: the 1.2.0 update left a truncated page that stayed
    on "Connexion…". Free space is checked before writing and logged at boot and
    during an update, to find the cause.
    [update_service.cpp]
2026-10-28 README: illustrations of the box and its cards
    Two AI-generated illustrations, based on renders of the 3D model (finger-joint
    version), until photos of real builds are available; captions say so.
2026-10-28 Render studio for the enclosure
    hardware/tools/render: a three.js page that renders the Onshape model (glTF
    export, not versioned) with procedural birch plywood, laser-charred edges, lit
    LEDs and wooden cards, plus a small local server that saves the images. Three
    views (closed box, box and cards, inside); make render starts it. The README
    illustrations were made from these renders.
2026-11-03 Saw cutting plan for the hand-made enclosure
    contours_to_cutplan.py derives guillotine cuts from the plate layout
    (horizontal strips, then vertical cuts, then trims) and writes a
    two-page A4 PDF: numbered plate diagram with the measure of each cut,
    then chamfers, notches, slots and drill positions per piece. Built by
    make cad for the manual version, so the box can be cut without a
    printed template.
2026-11-04 Laser LED cover with tabs, engraving layer in the DXF
    Castle version: the LED cover loses its two 45° bevels (square edges,
    19.1 mm wide, same LED-side face) and gets a tab at each end, through
    an inclined mortise in the partition and the right side
    (led_cover.fs, added to the Onshape document; the cover is moved in the
    layout so its tabs keep 2 mm from the right side).
    DXF: new GRAVURE layer with centring crosses on holes and rounded
    corners and each piece's name (ASCII), on the inner face. New contour
    kind P (hand-drilled hole, never cut): the castle bottom's 8 holes are
    now marked on the GRAVURE layer and in the PDF template.
    [totobox_castle_arriere.dxf, totobox_castle_bande_guide.dxf, totobox_castle_cloison.dxf, totobox_castle_cote_droit.dxf, totobox_castle_cote_gauche.dxf, totobox_castle_couvre_leds.dxf, totobox_castle_dessus.dxf, totobox_castle_facade.dxf]
2026-11-04 Home Assistant over MQTT
    The box announces itself to Home Assistant with MQTT discovery: state,
    current story, volume (bounded by the box limits), a stop button, SD card,
    lock and Wi-Fi signal. Every card placed becomes a Home Assistant tag and
    removing it is a device trigger; master cards are never published. A stop
    from Home Assistant keeps the bookmark and does not restart the story while
    the card stays on the box.
    - ha_rules: broker address, topics, discovery, state, commands (native tests)
    - card_flow: remote stop
    - HomeAssistantService: PubSubClient in a core 0 task, offline before sleep
    - settings in ConfigStore, /api/config and /api/status, mock server, page
    - docs: design, beginner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
    [app_types.h, card_flow.cpp, card_flow.h, config_store.cpp, ha_rules.cpp, ha_rules.h, ha_service.cpp, ha_service.h]
2026-11-08 Two cards on the reader, knob noise from the NFC field
    Two cards in the slot: the reader returns one, then no card for more than
    the removal delay, then the other. Each alternation stopped the story and
    started the other one, so the sound stuttered. card_flow now treats a
    different card seen less than 1 s after the last one as two cards: the
    story stops once (bookmark kept), the box shows a new TwoCards state (red
    blink, "Deux cartes posées" in the page, two_cards in Home Assistant), and
    the remaining card plays once it answers alone for 1.5 s.
    Encoder wires lying on the NFC antenna picked up the reader's field, which
    stays on during a search without card: dozens of phantom detents per tur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
    [app_types.h, card_flow.cpp, card_flow.h, ha_rules.cpp, led_controller.cpp, main.cpp, test_main.cpp, totobox_config.h]
2026-11-08 Wiring: fix the encoder wires away from the NFC antenna
    Route them along the right wall then the bottom, opposite the antenna, hold
    them with two dots of hot glue, and check the knob without a card once the
    box is closed.
2026-11-08 MP3 loudness at upload, file and folder download, trash fixes
    Upload: the page measures the loudness of each MP3 (BS.1770, same values
    as ffmpeg) by decoding the whole file in 512 KB slices, then shifts the
    global_gain of every granule by 1.5 dB steps, losslessly, like mp3gain.
    Target -16 LUFS, files within 1.5 dB left alone, raise capped by clipping
    (0.01 % of samples) and 12 dB; CRC-protected frames get a new CRC. A
    checkbox, on by default, turns it off.
    Download: GET /api/download sends an audio file, or a folder as a stored
    ZIP built on the fly (zip_stream: sizes known up front, CRC in a data
    descriptor). The box sends it in 20 ms slices from loop(), stays
    responsive, and stops it when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
    [library_paths.cpp, library_paths.h, main.cpp, test_main.cpp, web_admin.cpp, web_admin.h, zip_stream.cpp]
2026-11-08 Request guard decides the expected body of each route
    The upload route answered 415 json_required because web_admin told
    request_guard to expect JSON. The caller no longer chooses:
    request_guard::expectedBody() derives it from the method and the path
    (nothing for a GET, multipart for /api/upload, JSON for any other POST),
    and the tests cover each case, including a multipart body sent to another
    route.
    [request_guard.cpp, request_guard.h, test_main.cpp, web_admin.cpp, web_admin.h]
2026-11-08 Route table: lock and busy refusals in one place
    Every /api handler started with its own rejectIfLocked() and
    rejectIfBusy(), 22 copies that nothing tested. src/api_routes.cpp now
    lists each route with whether it is refused when the box is locked and
    while a story plays or a download runs; onApi() applies it before the
    handler, the upload applies it before writing, and a route missing from
    the table is treated as strictly as possible.
    Native tests check the table (unique routes, a locked box only exposes
    status, volume, unlock and lock; SD routes wait for the story), and
    scripts/test_api_routes.py checks that docs/api.md and the mock server
    say the same thing.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
    [api_routes.cpp, api_routes.h, test_main.cpp, web_admin.cpp, web_admin.h]
2026-11-08 Volume gauge on the LEDs for 1 s after the last change
    The gauge stayed 5 s. The unlock confirmation (whole strip white) keeps
    its 5 s through a duration stored with the overlay.
2026-11-08 Unlock animation: green bar opening from the center
    A master card used to light the whole strip white for 5 s. The strip
    now turns green for 0.3 s, then its LEDs go off pair by pair from the
    center to both ends in 0.6 s (led_layout::unlockLit, tested on the
    computer).
2026-11-08 Progress bar, card emoji and color, card search, SD space used
    The now-playing card shows a progress bar and the track duration, read
    from the audio library (activeDurationMs in /api/status).
    Each card can get an emoji and a color from a small palette, shown on its
    tile. Both live in CardBinding, checked by ConfigStore (same rules in the
    page), written only when set, and travel with the SD card backup. The
    bindings route now reads its body with ConfigStore::readBindings instead
    of a copy of it. A search field appears from nine cards on.
    The home page showed the free space rounded ("32 Go libres sur 32 Go" on
    an almost empty card); it now shows the space used.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
    [app_types.h, audio_service.cpp, audio_service.h, config_store.cpp, config_store.h, main.cpp, test_main.cpp, web_admin.cpp]
2026-11-08 Settings in three tabs, each saved on its own
    One dialog with nine sections and a single Save button, while the lock,
    backup and reset buttons acted at once: nobody could tell what was
    taken into account. Settings now have three tabs: Listening (volume
    limits, lock), Network (Wi-Fi, access point, Home Assistant) and Box
    (updates, info, backup, reset). Save sends only the visible tab and says
    what it saves; the update switches save as soon as they change. The box
    info also shows the SD space used.
2026-11-08 Multi-select, track order, cancellable upload queue, live position in card sheet
    - Files: select several entries to move, download or trash them at once.
    - Track order: drag or arrow buttons, files renamed with a number prefix,
    keeping the existing style (01_, 1 - ...); cards follow their track and a
    folder bookmark stays on the same track. Two-step rename on name swaps.
    - Upload: one request per file, per-file state, cancel button; a rejected
    file no longer stops the others. The box deletes a half-written file when
    an upload is aborted.
    - Card sheet shows the live position while that card plays.
    [web_admin.cpp]
2026-11-08 Return card emoji and color in /api/config
    The bindings in /api/config were serialized field by field and missed the
    new appearance fields, so the page fell back to the default look after
    saving. Reuse ConfigStore::writeBindings like the NVS and SD backup.
    [web_admin.cpp]
2026-11-08 Let long lists scroll in dialogs
    A list with rounded corners (overflow: hidden) was shrunk to the dialog
    height and clipped instead of scrolling the sheet body: the track order,
    move and folder picker dialogs could not reach their last items.
2026-11-08 Auto-scroll the track order list while dragging near its edges
    The list now scrolls by itself when a dragged track nears the top or
    bottom of the dialog, at a speed in pixels per second (dragScrollSpeed in
    lib.js, tested), and the dragged row follows the pointer when the wheel
    scrolls during a drag.
