thomas-lamure/totobox/(notices)

Notices in the files:
README.md:
Code: GPL-3.0-or-later
Matériel et docs: CC BY-SA 4.0
